lysol/isa-bracket/(commit log)

2020-04-03 beef up screwmounts
    [bracket.scad]
2020-04-03 adjust bracket thickness
    also adjusts everywhere to dynamically size based on
    bracket thickness, growing the top tab up instead of down
    [bracket.scad]
2020-04-04 make bracket thicker again
    [bracket.scad]
2020-04-04 reshape the reinforcement and make it rounded for fun
    [bracket.scad]
2020-04-06 attempt to fix the height issue with the top tab
    would not screw flush to the case
    [bracket.scad]
2020-04-06 beef up the screwmounts, one broke during install
    [bracket.scad]
2020-04-06 adjust top tab to match reality a bit
    [bracket.scad]
2020-04-06 make bracket thinner so it fits better
    [bracket.scad]
2020-04-06 add support for cf to ide adapters
    [bracket.scad]
2020-04-06 move x-reinforcement to accomodate cf card slot
    [bracket.scad]
2020-04-06 beef up the lip a bit
    [bracket.scad]
2020-04-06 remove minkowski to speed up renders, who cares
    [bracket.scad]
2020-04-06 fix thread distance for cf card adapter mounts, not the same as XT-IDE
    [bracket.scad]
2020-04-06 in the case of cf card adapters, move the screwmounts up
    had to also move the reinforcement up
    [bracket.scad]
2020-04-06 remove lil lip since it's not at the bottom of the bracket now
    [bracket.scad]
2020-04-07 beef up top tab to make it stronger
    I broke it while trying to release the print from its support
    [bracket.scad]
2020-04-07 remove x-reinforcement to simplify things
    [bracket.scad]
2020-04-07 beef up the screwmount tabs if cf slot enabled
    basically having em higher up makes it harder to screw in if they're not
    flush with the bottom
    [bracket.scad]
2020-04-07 switch from english threads to holes for m3 bolts + nuts
    [bracket.scad]
2020-04-07 make bracket a little thicker
    the bracket ends up being about too flimsy to insert cf cards into while
    installed. I think it would end up breaking, so I've adjusted stuff to
    make it more rigid in general. my tests with the bracket being too thick
    before seemed to be more about the case I was trying it in.
    [bracket.scad]
2020-04-08 remove library I'm no longer using
    [threads.scad]
